drytoastman/MiataECU/bom.ods

Sheet: Digikey
Qty | Num | Type | Value | Package | Parts | Digikey | Price
2 | 0.01 | C | 10pF | 805 | C18 C19 | 478-5779-1-ND (http://search.digikey.com/us/en/products/08051A100FAT2A/478-5779-1-ND/2136371) | $0.56 | $1.12
2 | 0.02 | C | 22pF | 805 | C16 C17 | 478-1308-1-ND (http://search.digikey.com/us/en/products/08055A220JAT2A/478-1308-1-ND/564340) | $0.23 | $0.46
1 | 0.1 | C | 100pF | 805 | C21 | 445-1329-1-ND (http://search.digikey.com/us/en/products/C2012C0G1H101J/445-1329-1-ND/567636) | $0.20 | $0.20
1 | 0.47 | C | 470pF | 805 | C9 | 478-1324-1-ND (http://search.digikey.com/us/en/products/08055A471JAT2A/478-1324-1-ND/564356) | $0.24 | $0.24
1 | 3.3 | C | 3.3nF | 805 | C6 | 478-5160-1-ND (http://search.digikey.com/us/en/products/08053A332JAT2A/478-5160-1-ND/1913250) | $0.42 | $0.42
2 | 10 | C | 10nF | 805 | C2 C3 | 478-3768-1-ND (http://search.digikey.com/us/en/products/08055C103JAT2A/478-3768-1-ND/1116466) | $0.41 | $0.82
2 | 33 | C | 33nF | 805 | C1 C4 | 478-3769-1-ND (http://search.digikey.com/us/en/products/08055C333JAT2A/478-3769-1-ND/1116467) | $0.46 | $0.92
7 | 100 | C | 100nF | 805 | C5 C7 C10 C12 C14 C15 C20 | 478-1395-1-ND (http://search.digikey.com/us/en/products/08055C104KAT2A/478-1395-1-ND/564427) | $0.16 | $1.12
1 | 4700 | C | 4.7uF | 805 | C8 | 399-3133-1-ND (http://search.digikey.com/us/en/products/C0805C475K8PACTU/399-3133-1-ND/551638) | $0.30 | $0.30
1 | 10000 | C | 10uF | 805 | C13 | 478-3273-1-ND (http://search.digikey.com/us/en/products/TAJR106K006RNJ/478-3273-1-ND/930065) | $1.24 | $1.24
1 | 47000 | C | 47uF | 805 | C11 | 493-2908-1-ND (http://search.digikey.com/us/en/products/F950J476MPAAQ2/493-2908-1-ND/1129197) | $1.16 | $1.16
1 | 10 | L | 10uH | 1206 | L1 | 587-2035-1-ND (http://search.digikey.com/us/en/products/LB3218T100K/587-2035-1-ND/1788982) | $0.13 | $0.13
1 | 0.12 | R | 120 | 805 | R16 | P120ACT-ND (http://search.digikey.com/us/en/products/ERJ-6GEYJ121V/P120ACT-ND/16552) | $0.04 | $0.04
5 | 1 | R | 1K | 805 | R6 R8 R9 R11 R17 | P1.0KACT-ND (http://search.digikey.com/us/en/products/ERJ-6GEYJ102V/P1.0KACT-ND/42833) | $0.04 | $0.20
2 | 2 | R | 2K | 805 | R10, R15 | P2.0KACT-ND (http://search.digikey.com/us/en/products/ERJ-6GEYJ202V/P2.0KACT-ND/81761) | $0.04 | $0.08
1 | 6.8 | R | 6.8K | 805 | R3 | P6.8KACT-ND (http://search.digikey.com/us/en/products/ERJ-6GEYJ682V/P6.8KACT-ND/42743) | $0.04 | $0.04
3 | 10 | R | 10K | 805 | R1 R2 R4 | P10KACT-ND (http://search.digikey.com/us/en/products/ERJ-6GEYJ103V/P10KACT-ND/43118) | $0.04 | $0.12
2 | 30 | R | 30K | 805 | R13 R14 | P30KACT-ND (http://search.digikey.com/us/en/products/ERJ-6GEYJ303V/P30KACT-ND/81785) | $0.04 | $0.08
2 | 100 | R | 100K | 805 | R5 R7 | P100KACT-ND (http://search.digikey.com/us/en/products/ERJ-6GEYJ104V/P100KACT-ND/692) | $0.04 | $0.08
1 | 1000 | R | 1M | 805 | R12 | P1.0MACT-ND (http://search.digikey.com/us/en/products/ERJ-6GEYJ105V/P1.0MACT-ND/82939) | $0.04 | $0.04
1 |  | U | AT90CAN64 | TQFP64 | IC1 | AT90CAN64-16AU-ND (http://search.digikey.com/us/en/products/AT90CAN64-16AU/AT90CAN64-16AU-ND/1245792) | $8.80 | $8.80
1 |  | U | LD1117S33 | SOT223 | IC3 | 497-1242-1-ND (http://search.digikey.com/us/en/products/LD1117S33TR/497-1242-1-ND/586242) | $0.54 | $0.54
1 |  | U | MCP7940N | MSOP08 | U10 | MCP7940N-I/MS-ND (http://search.digikey.com/us/en/products/MCP7940N-I%2FMS/MCP7940N-I%2FMS-ND/2651353) | $1.10 | $1.10
1 |  | U | MCP2551SN | SO8 | U2 | MCP2551-I/SN-ND (http://search.digikey.com/us/en/products/MCP2551-I%2FSN/MCP2551-I%2FSN-ND/509452) | $1.12 | $1.12
1 |  | U | TPIC8101 | SO20 | U3 | 296-24864-1-ND (http://search.digikey.com/us/en/products/TPIC8101DWRG4/296-24864-1-ND/2096446) | $7.44 | $7.44
2 |  | U | VND5N07 | DPAK | U4 U5 | 497-2481-5-ND (http://search.digikey.com/us/en/products/VND5N07/497-2481-5-ND/654692) | $1.95 | $3.90
1 |  | U | VNS3NV04D | SO8 | U6 | 497-3318-1-ND (http://search.digikey.com/us/en/products/VNS3NV04D13TR/497-3318-1-ND/654715) | $2.37 | $2.37
1 |  | U | MAX3378 | TSSOP14 | U7 | MAX3392EEUD+-ND (http://search.digikey.com/us/en/products/MAX3392EEUD%2B/MAX3392EEUD%2B-ND/1701962) | $3.43 | $3.43
1 |  | U | MMA7455 | LGA14 | U9 | MMA7455LT-ND (http://search.digikey.com/us/en/products/MMA7455LT/MMA7455LT-ND/1791487) | $2.02 | $2.02
1 |  | U | SCHMITT | TSOP6 | U11 | 568-4618-1-ND (http://search.digikey.com/scripts/DkSearch/dksus.dll?Detail&itemSeq=107348276&uq=634574432206221040) | $0.52 | $0.52
1 |  | Y | 16MHz | SMD2 | Y1 | 887-1086-1-ND (http://search.digikey.com/us/en/products/7A-16.000MAAJ-T/887-1086-1-ND/2118963) | $0.94 | $0.94
1 |  | Y | 32.768kHz | SMD2 | Y2 | 535-9537-1-ND (http://search.digikey.com/us/en/products/ABS10-32.768KHZ-7-T/535-9537-1-ND/1237004) | $1.13 | $1.13
1 |  | J | Header |  | J5 | A98184-ND (http://search.digikey.com/scripts/DkSearch/dksus.dll?Detail&itemSeq=107348280&uq=634574475137637920) | $2.49 | $2.49
1 |  | J | Plug |  | J5/match | A98174-ND (http://search.digikey.com/scripts/DkSearch/dksus.dll?Detail&itemSeq=107348281&uq=634574475137637920) | $8.15 | $8.15
 |  |  |  |  |  |  |  | $42.12

Sheet: Other
Qty | Value | Parts | Sparkfun
1 | Coin Battery Holder | BAT1 | PRT-07948 | $1.50
1 | 12mm Coil cell |  | PRT-00337 | $1.95
1 | Micro SD socket | U8 | PRT-00127 | $3.95
1 | Log Button Connector | J4 | PRT-09914 | $0.95
Qty | Value | Device | Parts | $8.35
 | 4pin header |  | JTAG1, JTAG2
 | headers/sockets |  | underneath
