drytoastman/MiataECU/PNP.brd

## EAGLE design PNP.brd (2016-11-13)

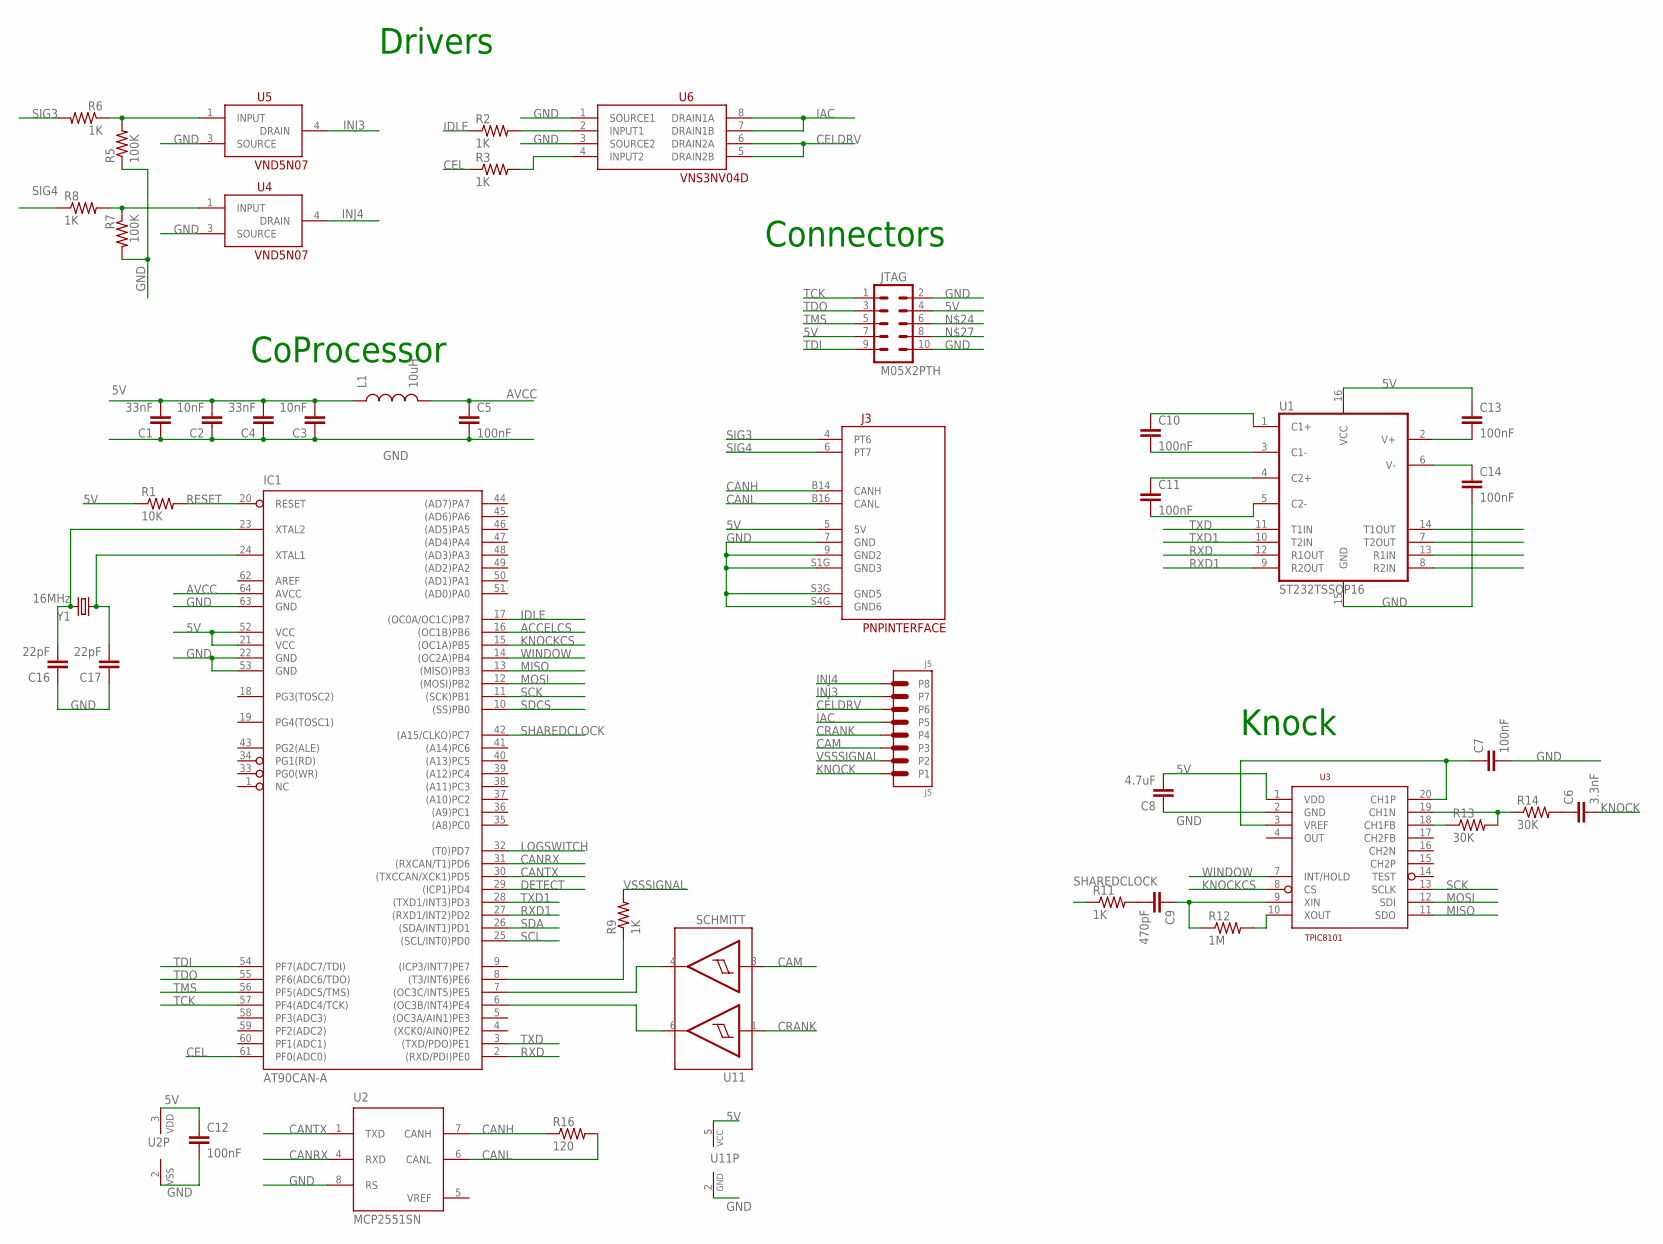
[picture p1: schematic PNP.sch]

Parts:
C1, C4: 33nF; 0805
C2, C3: 10nF; 0805
C5, C7, C10, C11, C12, C13, C14: 100nF; 0805
C6: 3.3nF; 0805
C8: 4.7uF; 0805
C9: 470pF; 0805
C16, C17: 22pF; 0805
IC1: AT90CAN-A; TQFP64
J3: PNPINTERFACE; PNPBOARD
J5: J5; TERMINAL8
JTAG: M05X2PTH; AVR_ICSP
L1: 10uH; 1210
R1: 10K; 0805
R2, R3, R6, R8, R9, R11: 1K; 0805
R5, R7: 100K; 0805
R12: 1M; 0805
R13, R14: 30K; 0805
R16: 120; 0805
U1: ST232TSSOP16; TSSOP16
U2: MCP2551SN; SO8
U3: TPIC8101; SO-20DW
U4, U5: VND5N07; DPAK
U6: VNS3NV04D; SO8
U11: SCHMITT; TSOP6
Y1: 16MHz; SM2-CRYSTAL-7ASERIES

Connections:
5V: C1.2, C2.2, C3.2, C4.2, C8.2, C12.1, C13.1, IC1.21 (VCC), IC1.52 (VCC), J3.5 (5V), JTAG.4, JTAG.7, L1.1, R1.1, U1.16 (VCC), U2.3 (VDD), U3.1 (VDD), U11.5 (VCC)
ACCELCS: IC1.16 ((OC1B)PB6)
AVCC: C5.1, IC1.64 (AVCC), L1.2
CAM: J5.P3, U11.3 (I2)
CANH: J3.B14 (CANH), R16.1, U2.7 (CANH)
CANL: J3.B16 (CANL), R16.2, U2.6 (CANL)
CANRX: IC1.31 ((RXCAN/T1)PD6), U2.4 (RXD)
CANTX: IC1.30 ((TXCCAN/XCK1)PD5), U2.1 (TXD)
CEL: IC1.61 (PF0(ADC0)), R3.1
CELDRV: J5.P6, U6.5 (DRAIN2B), U6.6 (DRAIN2A)
CRANK: J5.P4, U11.1 (I1)
DETECT: IC1.29 ((ICP1)PD4)
GND: C1.1, C2.1, C3.1, C4.1, C5.2, C7.2, C8.1, C12.2, C14.2, C16.1, C17.1, IC1.22 (GND), IC1.53 (GND), IC1.63 (GND), J3.7 (GND), J3.9 (GND2), J3.S1G (GND3), J3.S3G (GND5), J3.S4G (GND6), JTAG.2, JTAG.10, R5.1, R7.2, U1.15 (GND), U2.2 (VSS), U2.8 (RS), U3.2 (GND), U4.3 (SOURCE), U5.3 (SOURCE), U6.1 (SOURCE1), U6.3 (SOURCE2), U11.2 (GND)
IAC: J5.P5, U6.7 (DRAIN1B), U6.8 (DRAIN1A)
IDLE: IC1.17 ((OC0A/OC1C)PB7), R2.1
INJ3: J5.P7, U5.4 (DRAIN)
INJ4: J5.P8, U4.4 (DRAIN)
KNOCK: C6.2, J5.P1
KNOCKCS: IC1.15 ((OC1A)PB5), U3.8 (CS)
LOGSWITCH: IC1.32 ((T0)PD7)
MISO: IC1.13 ((MISO)PB3), U3.11 (SDO)
MOSI: IC1.12 ((MOSI)PB2), U3.12 (SDI)
unnamed: C6.1, R14.2
unnamed: R5.2, R6.1, U5.1 (INPUT)
unnamed: IC1.7 ((OC3C/INT5)PE5), U11.4 (O2)
unnamed: IC1.6 ((OC3B/INT4)PE4), U11.6 (O1)
unnamed: R2.2, U6.2 (INPUT1)
unnamed: C9.2, R11.2
unnamed: R3.2, U6.4 (INPUT2)
unnamed: R7.1, R8.2, U4.1 (INPUT)
unnamed: C10.1, U1.1 (C1+)
unnamed: C10.2, U1.3 (C1-)
unnamed: IC1.8 ((T3/INT6)PE6), R9.1
unnamed: C9.1, R12.1, U3.9 (XIN)
unnamed: C11.1, U1.4 (C2+)
unnamed: R12.2, U3.10 (XOUT)
unnamed: C16.2, IC1.23 (XTAL2), Y1.P$2 (2)
unnamed: C17.2, IC1.24 (XTAL1), Y1.P$1 (1)
unnamed: C11.2, U1.5 (C2-)
unnamed: C7.1, U3.3 (VREF), U3.20 (CH1P)
unnamed: C13.2, U1.2 (V+)
unnamed: C14.1, U1.6 (V-)
unnamed: R13.2, R14.1, U3.19 (CH1N)
unnamed: R13.1, U3.18 (CH1FB)
RESET: IC1.20 (RESET), R1.2
RXD: IC1.2 ((RXD/PDI)PE0), U1.12 (R1OUT)
RXD1: IC1.27 ((RXD1/INT2)PD2), U1.9 (R2OUT)
SCK: IC1.11 ((SCK)PB1), U3.13 (SCLK)
SCL: IC1.25 ((SCL/INT0)PD0)
SDA: IC1.26 ((SDA/INT1)PD1)
SDCS: IC1.10 ((SS)PB0)
SHAREDCLOCK: IC1.42 ((A15/CLKO)PC7), R11.1
SIG3: J3.4 (PT6), R6.2
SIG4: J3.6 (PT7), R8.1
TCK: IC1.57 (PF4(ADC4/TCK)), JTAG.1
TDI: IC1.54 (PF7(ADC7/TDI)), JTAG.9
TDO: IC1.55 (PF6(ADC6/TDO)), JTAG.3
TMS: IC1.56 (PF5(ADC5/TMS)), JTAG.5
TXD: IC1.3 ((TXD/PDO)PE1), U1.11 (T1IN)
TXD1: IC1.28 ((TXD1/INT3)PD3), U1.10 (T2IN)
VSSSIGNAL: J5.P2, R9.2
WINDOW: IC1.14 ((OC2A)PB4), U3.7 (INT/HOLD)

Notes on the sheet:
Drivers
Knock
Connectors
CoProcessor

Board: 2 copper layers, 42 parts (0 on the bottom side), 56 nets, no tracks yet.
