drytoastman/MiataECU/avr/test.c

uint8 block0[512] = {
	0xEB, 0x00, 0x90, 0x20, 0x20, 0x20, 0x20, 0x20, 0x20, 0x20, 0x20, 0x00, 0x02, 0x20, 0x08, 0x00, 
	0x02, 0x00, 0x02, 0x00, 0x00, 0xF8, 0xF8, 0x00, 0x3F, 0x00, 0x20, 0x00, 0xE8, 0x00, 0x00, 0x00, 
	0x18, 0xED, 0x1E, 0x00, 0x80, 0x00, 0x29, 0x13, 0x18, 0xFD, 0xE0, 0x20, 0x20, 0x20, 0x20, 0x20, 
	0x20, 0x20, 0x20, 0x20, 0x20, 0x20, 0x46, 0x41, 0x54, 0x31, 0x36, 0x20, 0x20, 0x20, 0x00, 0x00, 
	0x00, 0x00, 0x00, 0x00, 0x00, 0x00, 0x00, 0x00, 0x00, 0x00, 0x00, 0x00, 0x00, 0x00, 0x00, 0x00, 
	0x00, 0x00, 0x00, 0x00, 0x00, 0x00, 0x00, 0x00, 0x00, 0x00, 0x00, 0x00, 0x00, 0x00, 0x00, 0x00, 
	0x00, 0x00, 0x00, 0x00, 0x00, 0x00, 0x00, 0x00, 0x00, 0x00, 0x00, 0x00, 0x00, 0x00, 0x00, 0x00, 
	0x00, 0x00, 0x00, 0x00, 0x00, 0x00, 0x00, 0x00, 0x00, 0x00, 0x00, 0x00, 0x00, 0x00, 0x00, 0x00, 
	0x00, 0x00, 0x00, 0x00, 0x00, 0x00, 0x00, 0x00, 0x00, 0x00, 0x00, 0x00, 0x00, 0x00, 0x00, 0x00, 
	0x00, 0x00, 0x00, 0x00, 0x00, 0x00, 0x00, 0x00, 0x00, 0x00, 0x00, 0x00, 0x00, 0x00, 0x00, 0x00, 
	0x00, 0x00, 0x00, 0x00, 0x00, 0x00, 0x00, 0x00, 0x00, 0x00, 0x00, 0x00, 0x00, 0x00, 0x00, 0x00, 
	0x00, 0x00, 0x00, 0x00, 0x00, 0x00, 0x00, 0x00, 0x00, 0x00, 0x00, 0x00, 0x00, 0x00, 0x00, 0x00, 
	0x00, 0x00, 0x00, 0x00, 0x00, 0x00, 0x00, 0x00, 0x00, 0x00, 0x00, 0x00, 0x00, 0x00, 0x00, 0x00, 
	0x00, 0x00, 0x00, 0x00, 0x00, 0x00, 0x00, 0x00, 0x00, 0x00, 0x00, 0x00, 0x00, 0x00, 0x00, 0x00, 
	0x00, 0x00, 0x00, 0x00, 0x00, 0x00, 0x00, 0x00, 0x00, 0x00, 0x00, 0x00, 0x00, 0x00, 0x00, 0x00, 
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
	0x10, 0x3F, 0x10, 0x3F, 0x00, 0x00, 0x62, 0x95, 0x10, 0x3F, 0xF0, 0xE6, 0x00, 0x40, 0x00, 0x00, 
	0xE5, 0x38, 0x34, 0x34, 0x33, 0x39, 0x36, 0x5F, 0x20, 0x20, 0x20, 0x10, 0x00, 0x69, 0x39, 0x6F, 
	0x11, 0x3F, 0x11, 0x3F, 0x00, 0x00, 0x3A, 0x6F, 0x11, 0x3F, 0xF0, 0xE6, 0x00, 0x40, 0x00, 0x00
};
