drytoastman/MiataECU/(commit log)

2011-10-15 base files
    [InjectorDriver.sch, MiataPNP.sch, Relay.sch]
2011-10-16 more progress at first version
    [InjectorDriver.sch, MiataPNP.sch, Relay.sch]
2011-10-17 move to PH board mounting
    [MiataPNP.sch, Relay.sch]
2011-10-17 add power supply, remove some unecessary stuff
    [MiataPNP.sch]
2011-10-19 move to power supply from MS V3 board
    [MiataPNP.sch]
2011-10-19 go for mosfet SMD to remove excess components
    [MiataPNP.sch]
2011-10-20 after backport of footprints
    [MiataPNP.sch]
2011-10-20 perhaps done with the schematic portion, hopefully
    [MiataPNP.brd, MiataPNP.sch]
2011-10-20 reorg directory as coprocessor components will go on their own board
    [CoProcessor.sch, InjectorDriver.sch, MiataPNP.brd, MiataPNP.sch, Relay.sch]
2011-10-20 fix up for new arrangement
    [CoProcessor.sch, MiataPNP.sch]
2011-10-22 save point
    [CoProcessor.sch, MiataPNP.sch]
2011-10-22 move coproc back onto mainboard to save PCB material
    [CoProcessor.sch, MiataPNP.sch]
2011-10-25 remove old coproc dir, looking at alternator circuits
    [CoProcessor.sch, MiataPNP.sch]
2011-10-26 bring back injector driver onto main board
    [CoProcessor.sch, InjectorDriver.sch, MiataPNP.sch, PowerSupply.sch]
2011-10-26 fix ups for drivers and tests import into board
    [CoProcessor.sch, InjectorDriver.sch, MiataPNP.sch, PowerSupply.sch]
2011-10-26 forget flyback
    [flyback.sch]
2011-10-29 more work, split complexity into more sheets
    [CoProcessor.sch, InjectorDriver.sch, MiataPNP.sch, PowerSupply.sch, accelerometer.sch, alternator.sch, flyback.sch]
2011-10-29 use 'isolator' for accel circuit and ISP protection
    [CoProcessor.sch, InjectorDriver.sch, MiataPNP.sch, PowerSupply.sch, accelerometer.sch, alternator.sch, flyback.sch]
2011-10-31 starting some board layout, need to double check footprints, some where wonky
    [MiataPNP.brd, knock.sch]
2011-11-02 lots of stuff and board busing
    [CoProcessor.sch, InjectorDriver.sch, MiataPNP.brd, MiataPNP.sch, PowerSupply.sch, accelerometer.sch, alternator.sch, flyback.sch]
2011-11-02 temp commit, changing direction yet again
    [CoProcessor.sch, InjectorDriver.sch, MiataPNP.sch, PowerSupply.sch, accelerometer.sch, alternator.sch, flyback.sch, knock.sch]
2011-11-04 moved back to eagle, going for small single board addon rather than redoing entire board
    [PNP.brd, PNP.sch, accelerometer.sch, alternator.sch, coproc.sch, knock.sch]
2011-11-05 save status as I'm going to dump the alternator control
    [PNP.brd, PNP.sch]
2011-11-06 seemingly finalized schematic, starting layout
    [PNP.brd, PNP.sch]
2011-11-07 an actual routed board
    [PNP.brd, PNP.sch]
2011-11-07 some cleanup and labelling updates
    [PNP.brd, PNP.sch]
2011-11-07 add cam file for output
    [PNP.brd, PNP.sch]
2011-11-08 why not add a battery backed up RTC
    [PNP.brd, PNP.sch]
2011-11-08 enlarge and put battery on board
    [PNP.brd, PNP.sch]
2011-11-08 some more last tweaks
    [PNP.brd, PNP.sch]
2011-11-10 label cleanup
    [PNP.brd, PNP.sch]
2011-11-11 couple part details, bigger caps around microSD socket for card insertion, swap to bidi MAX3378 as 3392 is not in stock anywhere
    [PNP.brd, PNP.sch, bom.ods]
2011-11-12 cleanup, move old files out of the way for now
    [CoProcessor.sch, InjectorDriver.sch, MiataPNP.brd, MiataPNP.sch, PowerSupply.sch, accelerometer.sch, alternator.sch, coproc.sch]
2011-11-19 update board for changes including CAM/CRANK input or lots of minor things
    [PNP.brd, PNP.sch]
2011-11-20 more layout work
    [PNP.brd, PNP.sch]
2011-11-20 yet more layout adjustments
    [PNP.brd, PNP.sch]
2011-11-21 little changes as we update the bom
    [PNP.brd, PNP.sch, bom.ods]
2012-04-09 some hacking on the can bus part
    [PNP.brd]
2012-04-18 save progress in getting fimrware working, canbus works, idle output seems okay, setting SCK to output handings JTAG debugging session though so can't test knock sensor SPI interface yet
2012-04-18 SPI appears to work now that defunct level converter chip is removed (no 3.3V on board right now)
2012-04-22 better integration with TunerStudio, now set things like the knock sensor config values as well
2012-05-17 work on knock sensor inputs, controls and general debugging
2012-07-08 start removing unused pieces
    [PNP.brd, PNP.sch]
2016-11-13 opened with latest eagle, also have some changes still floating on my system at home, commit them all so I remove the local copy
    [PNP.brd, PNP.sch]
